JamesonRGrieve/3shub-dcc-repair/README.md

# 3shub-dcc-repair
Repair pieces for Digital Climate Control units in Mitsubishi 3000GT/GTO's and Dodge Stealths.
