JamesonRGrieve/3shub-dcc-repair/3s_dcc_side_tab_repair.stl

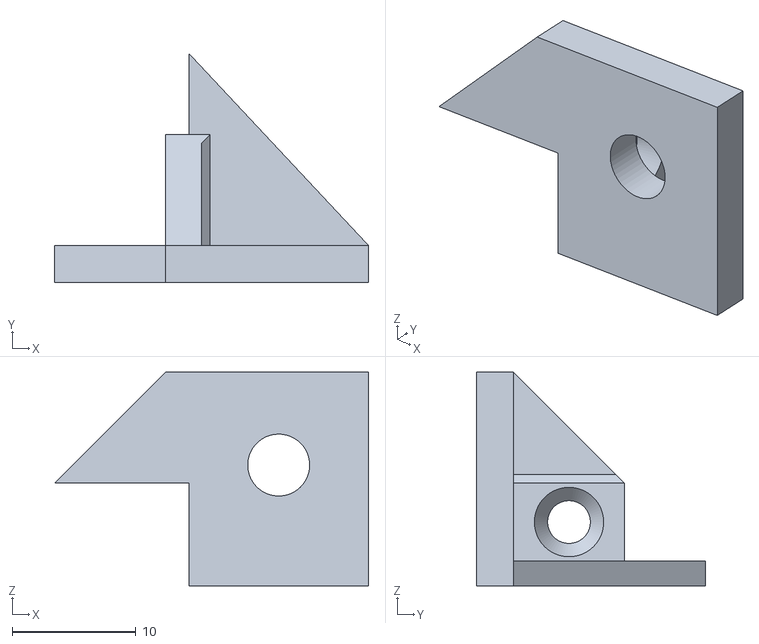
[picture p3: CAD file, 2024-01-18]
3s_dcc_side_tab_repair.stl
25.4 x 18.5 x 17.2
