JamesonRGrieve/3shub-dcc-repair/3s_dcc_top_tab_repair.stl

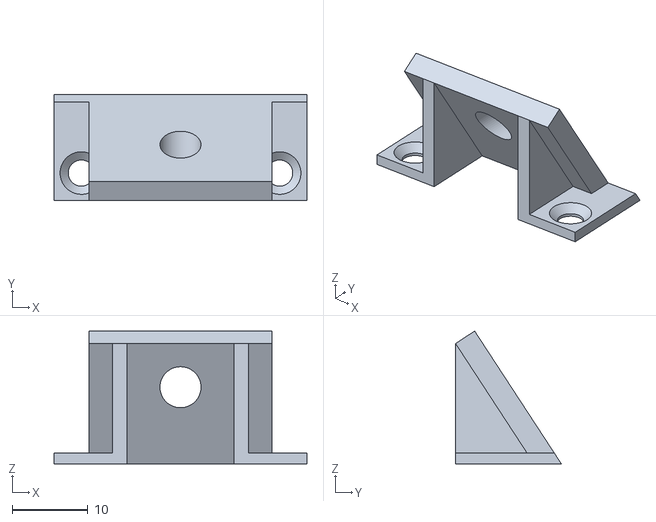
[picture p4: CAD file, 2024-01-18]
3s_dcc_top_tab_repair.stl
33.3 x 13.9 x 17.5
